ajadismail2/Visual-place-learning/readme.md

# Visual place-learning apparatus

Practical documentation for assembling and operating the visual place-learning arena.

## Build and check

Requires Python 3.10 or later.

[Website](https://ajadismail2.github.io/Visual-place-learning/)
