ajadismail2/Visual-place-learning/docs/hardware/arena-and-dimensions.md

---
title: Arena and dimensions
description: The walking surface, perimeter, glass cover and supporting structure.
section: Hardware
---
A ring and glass cover enclose the temperature-controlled walking surface, with an LED panorama around it and a camera above.

## Current arena specification

| Feature | Documented configuration |
| --- | --- |
| Background | 60 Peltier modules operated as one circuit |
| Cooling Peltier plates | Four separately driven Peltier plates, A–D |
| Visual enclosure | Eight P4 HUB75 panels, 64 × 32 pixels each, 4mm Pixel Pitch |
| Thermal Ring dimensions | 8 inches |
| Glass cover | 2-3mm thick Annealed glass |
| Background sensor setpoint | 34.8 °C |
| Ring sensor setpoint | 50 °C |

## Walking surface and Peltier plates

<figure markdown="1" style="border: 1px solid #d6d6d6; padding: 12px; margin: 24px 0; text-align: center;">

60-Peltier background array

<figcaption>60-Peltier background array.</figcaption>

</figure>

Mount the four Peltier plates flush with the background, with no accessible gaps.

Label the Peltier plates A–D using the tested driver mapping, and retain these labels in recordings and analysis.

## Base and mounts

Mount the carrier on a rigid, level base. Supports and cables must not tilt the floor or obstruct the camera.

See [CAD and printed parts](../cad/parts-and-step-files.md) for the component overview.

## Ring and glass cover

The ring and glass cover enclose the walking surface. See [Thermal ring and glass cover](thermal-ring-and-glass-cover.md) for fit and handling.
