ajadismail2/Visual-place-learning/docs/hardware/overview.md

---
title: Hardware
description: Arena, thermal control, visual display and recording.
section: Hardware
---

<figure markdown="1" style="border: 1px solid #d6d6d6; padding: 12px; margin: 24px 0; text-align: center;">

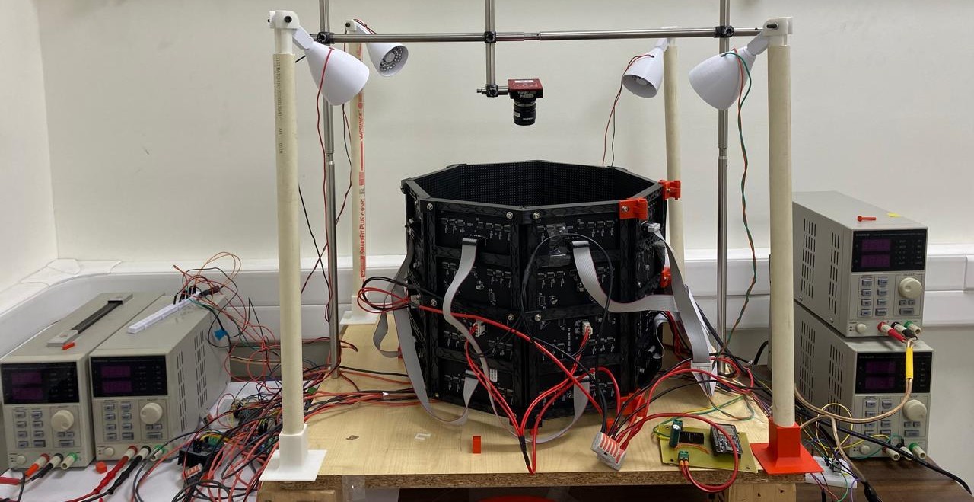
[picture p3: docs/hardware/images/full-arena.jpeg]
Arena viewed from above


<figcaption>Visual Place Learning Arena.</figcaption>

</figure>

The apparatus combines a heated walking arena, four cooling Peltier plates, an LED panorama and overhead video recording.

## Experimental setup

One Peltier plate cools during each trial while the other three heat. The Peltier-plate ESP32 synchronises the selected position with the visual panorama; the background and ring run independent temperature-control loops.

The Setup in total consists of the Peltier arena, Peltier temperature system, LED display, thermal ring and glass cover, illumination,wiring and cameras.

## Configuration

Pin maps and timings match the published sketches. Supply ratings and fabrication tolerances depend on the installed components.

[Equipment list](equipment-and-materials.md) · [Software setup](../software/install-and-upload.md) · [CAD parts](../cad/parts-and-step-files.md)
