ajadismail2/Visual-place-learning/docs/hardware/peltier-temperature-system.md

---
title: Peltier temperature system
description: Peltier plates, series wiring and the shared aluminium heat sink.
section: Hardware
---
A Peltier module transfers heat from one face to the other when current passes through it. Reversing the current swaps the hot and cold faces. Cooling depends on removing heat from the hot face.

<figure markdown="1" style="border: 1px solid #d6d6d6; padding: 12px; margin: 24px 0; text-align: center;">

Peltier module

<figcaption>Peltier module.</figcaption>

</figure>

<figure markdown="1" style="border: 1px solid #d6d6d6; padding: 12px; margin: 24px 0; text-align: center;">

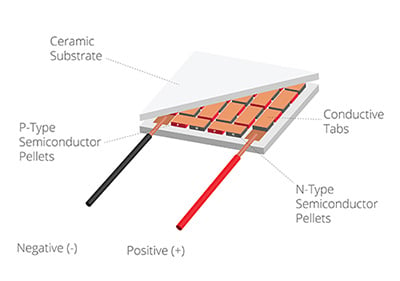
[picture p6: docs/hardware/images/peltierplateinsideworking.jpg]
Internal structure of a Peltier module


<figcaption>Internal structure of a Peltier module.</figcaption>

</figure>

## Arena arrangement

The background uses 60 Peltier modules connected in series to a single power source. The same current passes through every module, and their voltage drops add together.

Four separate Peltier plates at positions A–D provide the cooling locations within the heated background.

## Shared heat sink

The Peltier modules share a common heat sink: an aluminium plate 4–5 mm thick beneath the arena. Good thermal contact spreads heat into the plate, while airflow beneath it helps carry heat away.
