ajadismail2/Visual-place-learning/docs/hardware/index.md

---
title: Hardware
description: Arena, thermal control, visual display and recording.
section: Hardware
---
The apparatus combines a heated walking arena, four cooling Peltier plates, an LED panorama and overhead video recording.

## Experimental setup

One Peltier plate cools during each trial while the other three heat. The Peltier-plate ESP32 synchronises the selected position with the visual panorama; the background and ring run independent temperature-control loops.

## Assembly

| Component | Assembly checks |
| --- | --- |
| [Arena](../hardware/arena.md) | Level floor, secure supports, sealed Peltier-plate edges |
| [Wiring](../hardware/wiring.md) | Board labels, pin assignments, supply ratings |
| [Peltier temperature system](peltier.md) | Background feedback, A–D mapping and temperature response |
| [LED display](led-panels.md) | Panel order, orientation, bar dimensions |
| [Glass cover](glass-cover.md) | Fit, clearance, camera view |
| [Illumination](illumination.md) | Uniformity, mounting, reflections |
| [Cameras](imaging.md) | Focus, calibration, timing |

## Configuration

Pin maps and timings match the published sketches. Supply ratings and fabrication tolerances depend on the installed components.

[Equipment list](../hardware/equipment.md) · [Software setup](../software/upload.md) · [CAD parts](../cad/index.md)
