ajadismail2/Visual-place-learning/docs/hardware/four-channels.md

---
title: Peltier temperature system
---
<meta http-equiv="refresh" content="0; url=../peltier/#four-cooling-peltier-plates">
<script>window.location.replace("../peltier/#four-cooling-peltier-plates");</script>
The four cooling Peltier plates are documented in [Peltier temperature system](peltier.md#four-cooling-peltier-plates).
