ajadismail2/Visual-place-learning/docs/hardware/thermal-coupling.md

---
title: Peltier temperature system
---
<meta http-equiv="refresh" content="0; url=../peltier/">
<script>window.location.replace("../peltier/");</script>
See [Peltier temperature system](peltier.md).
