ajadismail2/Visual-place-learning/docs/hardware/visual-angle.md

---
title: LED display geometry
---
<meta http-equiv="refresh" content="0; url=../led-panels/">
<script>window.location.replace("../led-panels/");</script>
This material is now in [LED display](led-panels.md#setting-the-bar-width).
