ajadismail2/Visual-place-learning/docs/design/3d_design.md

# 3D Mechanical Design

This section contains the mechanical design files for the visual place learning apparatus.

The designs were created in Onshape and are provided here for reference, reuse, and modification.

[Onshape Link](https://cad.onshape.com/documents/b5f54554fffaaa542def4b71/w/fa5ba09e96b052a03cbcd971/e/47a6f2f114aad485d6089ac8)
