ajadismail2/Visual-place-learning/docs/index.md

---
title: Visual place learning in Drosophila
description: A custom-built system for studying visually guided place learning in individual Drosophila.
section: Home
---

# Visual place learning in Drosophila

This custom-built system is used to study how *Drosophila melanogaster* learns the location of a cool target from surrounding visual cues. This adapts the place-learning assay published by Ofstad, Zuker and Reiser in 2011 using accessible electronics and locally fabricated parts. [1](#reference)

The documentation covers:

- **Experimental procedure:** preparing the apparatus, running trials and recording the experiment.
- **Hardware and assembly:** the arena, Peltier temperature system, visual display, illumination and cameras.
- **Controller software:** installation, configuration and operation of the Arduino and ESP32 programs.
- **Tracking and analysis:** AMADEUS tracking, target registration and behavioural measurements.

This documentation describes the current apparatus and will be updated as the system develops.

## Documentation

1. [Hardware](hardware/overview.md) — components, construction, wiring and imaging.
2. [Software](software/how-the-programs-work.md) — controller programs, installation and operation.
3. [Analysis](analysis/ANALYSISWORKFLOW.md) — tracking, target registration and behavioural measurements.
4. [CAD](cad/parts-and-step-files.md) — editable STEP files for fabricated parts.
5. [Resources](resources/downloads-and-references.md) — downloads, checksums and technical references.

<p class="source-note" id="reference"><strong>1 · Reference</strong><br>Ofstad, T. A., Zuker, C. S. &amp; Reiser, M. B. <em>Visual place learning in Drosophila melanogaster.</em> Nature 474, 204–207 (2011). <a href="https://doi.org/10.1038/nature10131">doi:10.1038/nature10131</a> · <a href="https://pmc.ncbi.nlm.nih.gov/articles/PMC3169673/">Full text</a></p>
