ajadismail2/Visual-place-learning/docs/cad/index.md

---
title: CAD and fabricated parts
description: STEP models and assembly notes for the structural, display, lighting and thermal parts of the arena.
section: CAD
---
Six editable STEP models cover the arena supports, display enclosure, lighting, thermal ring and target registration.

## 01 · Structural baseplate

The wooden baseplate fixes the arena and supports in position. The geometry can also be cut from acrylic, aluminium or another rigid sheet.

[Download the baseplate STEP file](../downloads/cad/wooden-baseplate.step)

<div class="photo-pair"><figure class="photo-slot" data-photo-id="cad-baseplate-part"><figcaption><span>Photo · C01</span><strong>Structural baseplate</strong></figcaption></figure><figure class="photo-slot" data-photo-id="cad-baseplate-fit"><figcaption><span>Photo · C02</span><strong>Baseplate beneath the arena</strong></figcaption></figure></div>

## 02 · LED matrix octagon and access hinge

Printed TPU or PLA legs hold eight 64 × 32 panels in an octagon. One hinged panel opens for loading flies and returns to its recording position.

[Download the LED matrix octagon STEP file](../downloads/cad/led-matrix-octagon.step)

<div class="photo-pair"><figure class="photo-slot" data-photo-id="cad-octagon-part"><figcaption><span>Photo · C03</span><strong>Eight-panel LED octagon</strong></figcaption></figure><figure class="photo-slot" data-photo-id="cad-hinge-fit"><figcaption><span>Photo · C04</span><strong>Openable panel and hinges</strong></figcaption></figure></div>

## 03 · Infrared-light stand

A PVC support carries a printed lampshade, infrared array and diffuser. A printed tube can replace the PVC pipe.

[Download the IR light stand STEP file](../downloads/cad/ir-light-stand.step)

<div class="photo-pair"><figure class="photo-slot" data-photo-id="cad-ir-stand"><figcaption><span>Photo · C05</span><strong>PVC stand and printed lampshade</strong></figcaption></figure><figure class="photo-slot" data-photo-id="cad-ir-array"><figcaption><span>Photo · C06</span><strong>IR array and diffuser</strong></figcaption></figure></div>

## 04 · Thermal ring

The PLA ring contains a copper-wire resistive heater. Small openings provide air exchange.

[Download the thermal ring STEP file](../downloads/cad/thermal-ring.step)

<div class="photo-pair"><figure class="photo-slot" data-photo-id="cad-ring-part"><figcaption><span>Photo · C07</span><strong>Printed thermal ring</strong></figcaption></figure><figure class="photo-slot" data-photo-id="cad-ring-wire"><figcaption><span>Photo · C08</span><strong>Copper-wire path and ventilation gaps</strong></figcaption></figure></div>

## 05 · Cool-spot registration mask

Image the mask before each experiment to register the four target positions. Remove it before introducing flies without changing camera framing.

[Download the cool-spot mask STEP file](../downloads/cad/cool-spot-mask.step)

<div class="photo-pair"><figure class="photo-slot" data-photo-id="cad-mask-part"><figcaption><span>Photo · C09</span><strong>Cool-spot registration mask</strong></figcaption></figure><figure class="photo-slot" data-photo-id="cad-mask-view"><figcaption><span>Photo · C10</span><strong>Mask visible in the camera image</strong></figcaption></figure></div>

## 06 · Peltier-plate holder and fan support

The holder stabilises the baseplate around the four Peltier plates and supports a fan below. Underside airflow removes heat from the cooling hardware.

[Download the Peltier-plate holder STEP file](../downloads/cad/peltier-tile-holder.step)

<div class="photo-pair"><figure class="photo-slot" data-photo-id="cad-tile-holder"><figcaption><span>Photo · C11</span><strong>Peltier-plate holder</strong></figcaption></figure><figure class="photo-slot" data-photo-id="cad-fan-fit"><figcaption><span>Photo · C12</span><strong>Fan position beneath the baseplate</strong></figcaption></figure></div>
