ajadismail2/Visual-place-learning/docs/assets/analysis/analysis-gui.png

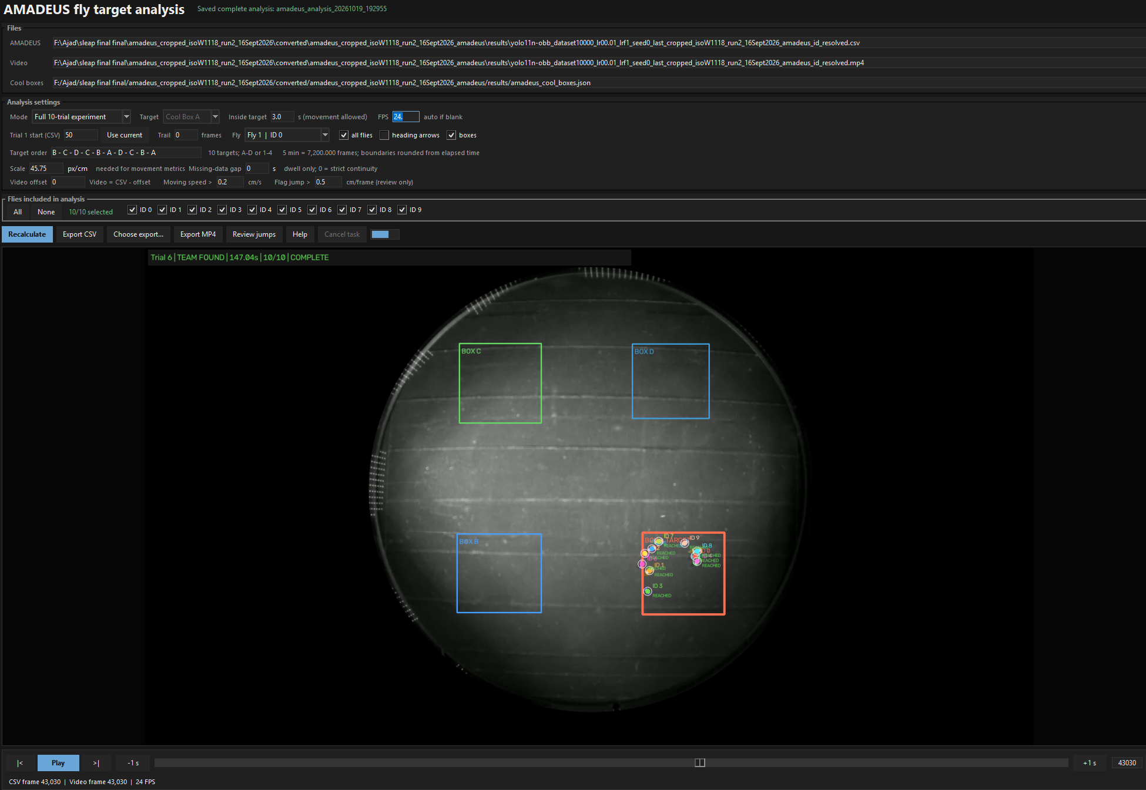
docs/assets/analysis/analysis-gui.png
