ajadismail2/Visual-place-learning/docs/cad/images/Octagon-Holder.png

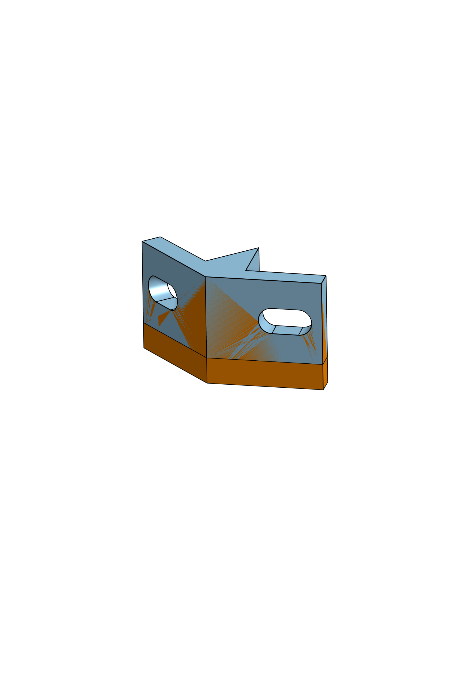
docs/cad/images/Octagon-Holder.png
