ajadismail2/Visual-place-learning/docs/cad/images/Peltier Tile Holder.png

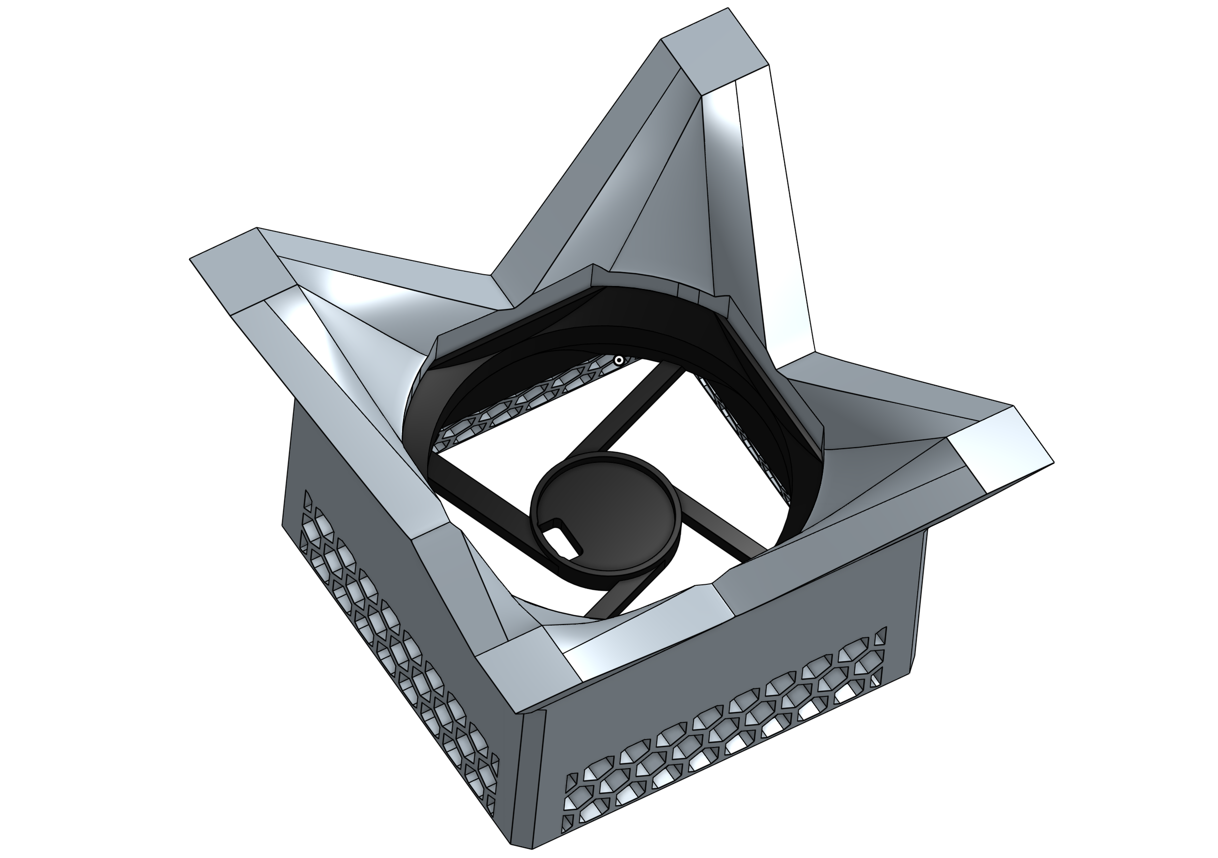
docs/cad/images/Peltier Tile Holder.png
