ajadismail2/Visual-place-learning/docs/cad/images/PVC IR STANDE.png

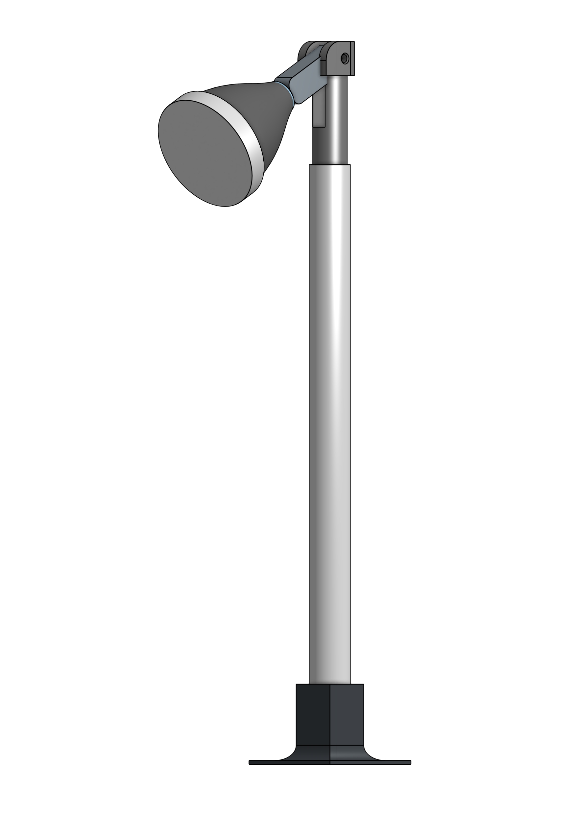
docs/cad/images/PVC IR STANDE.png
