ajadismail2/Visual-place-learning/docs/downloads/website-dynamic-qr.png

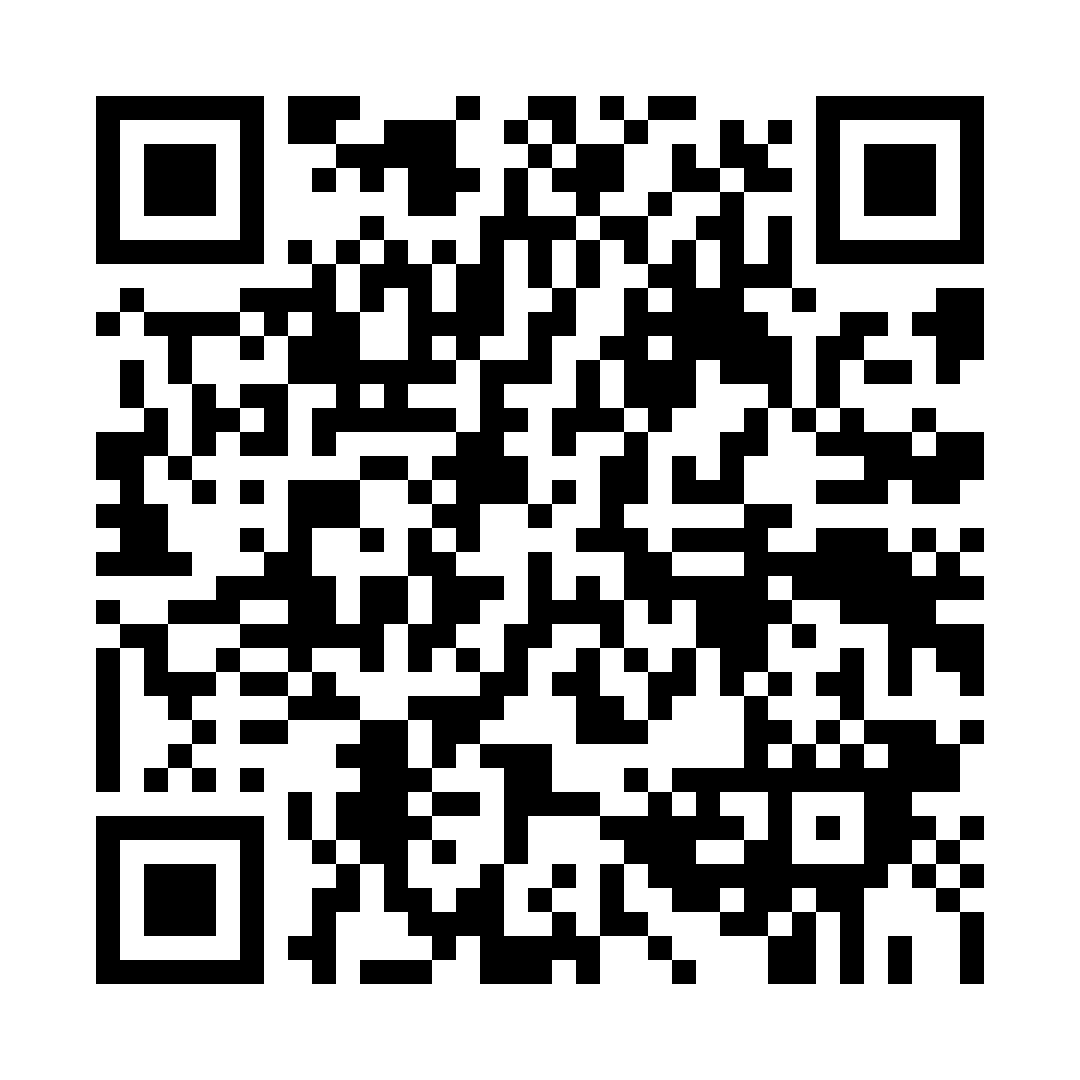
docs/downloads/website-dynamic-qr.png
