ajadismail2/Visual-place-learning/docs/downloads/website-qr.png

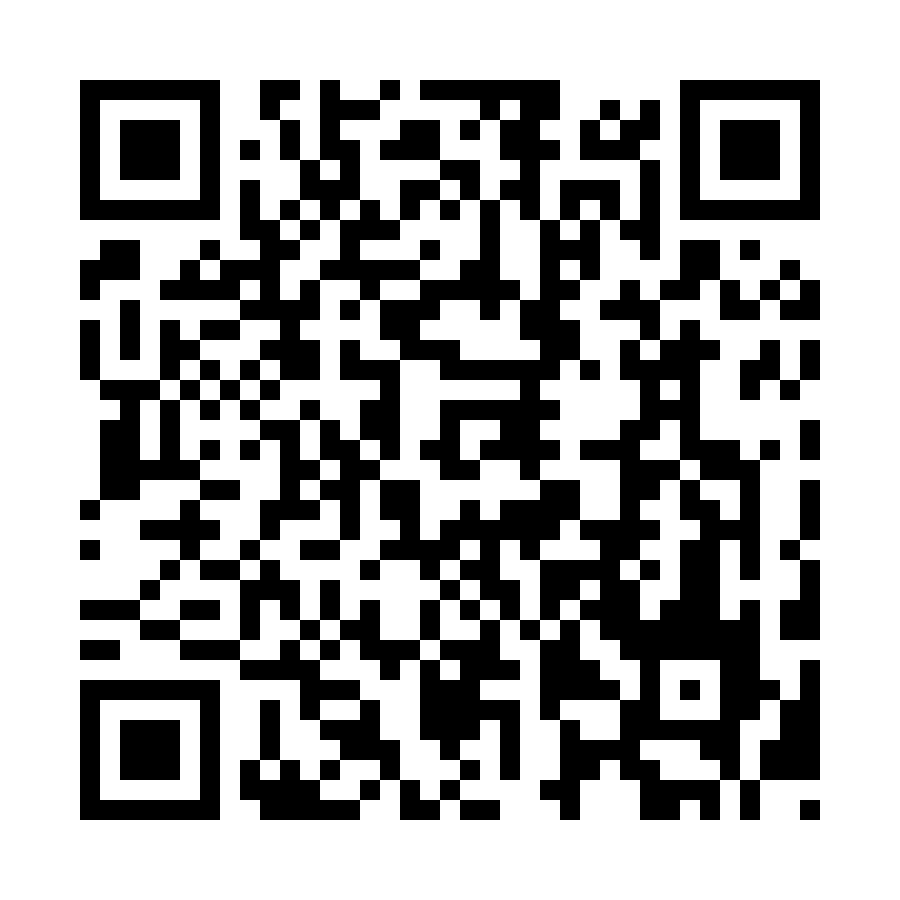
docs/downloads/website-qr.png
