ajadismail2/Visual-place-learning/docs/hardware/images/3dprint.png

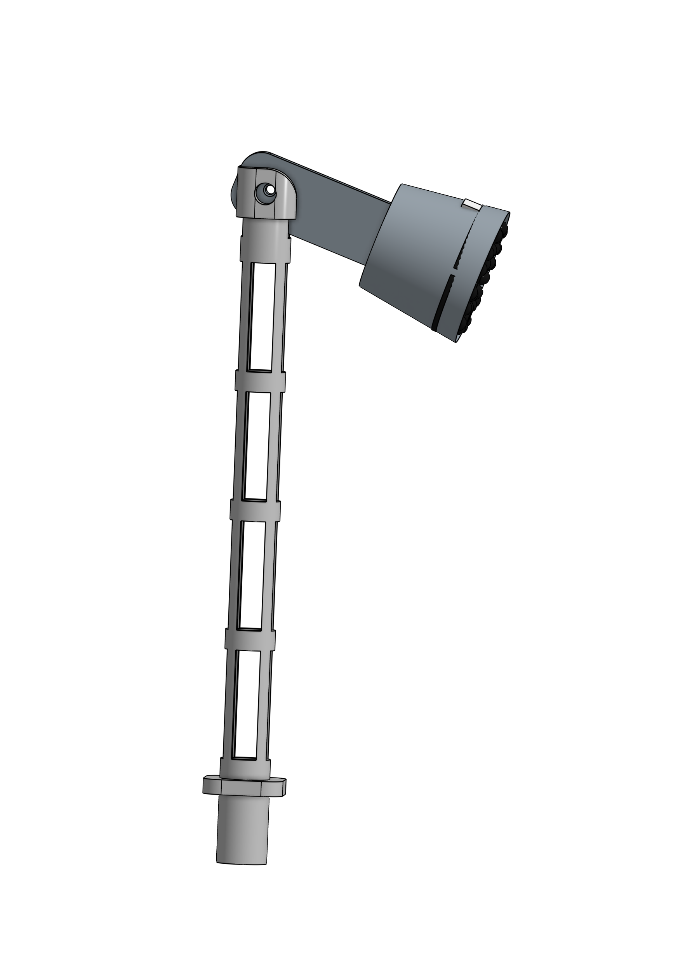
docs/hardware/images/3dprint.png
