ajadismail2/Visual-place-learning/docs/hardware/images/arduinouno.jpg

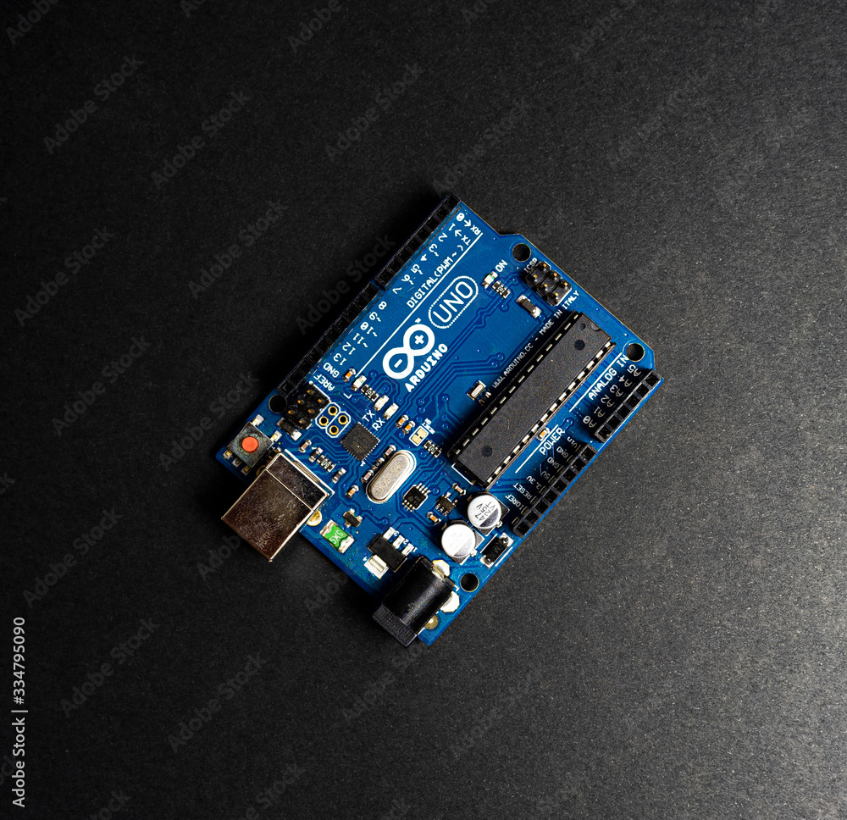
docs/hardware/images/arduinouno.jpg
