ajadismail2/Visual-place-learning/docs/hardware/images/circleflatglass__37330.jpg

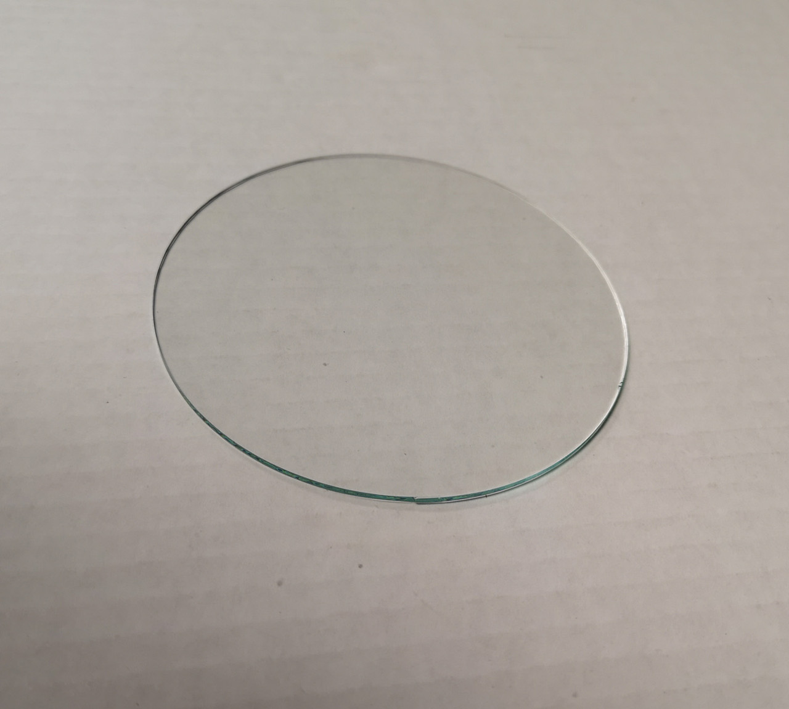
docs/hardware/images/circleflatglass__37330.jpg
