ajadismail2/Visual-place-learning/docs/hardware/images/full.png

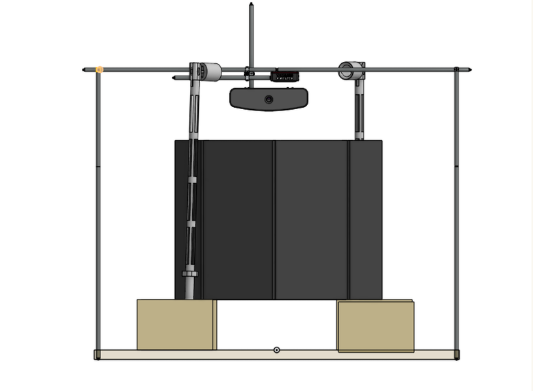
docs/hardware/images/full.png
