ajadismail2/Visual-place-learning/docs/hardware/images/Part Studio 1.png

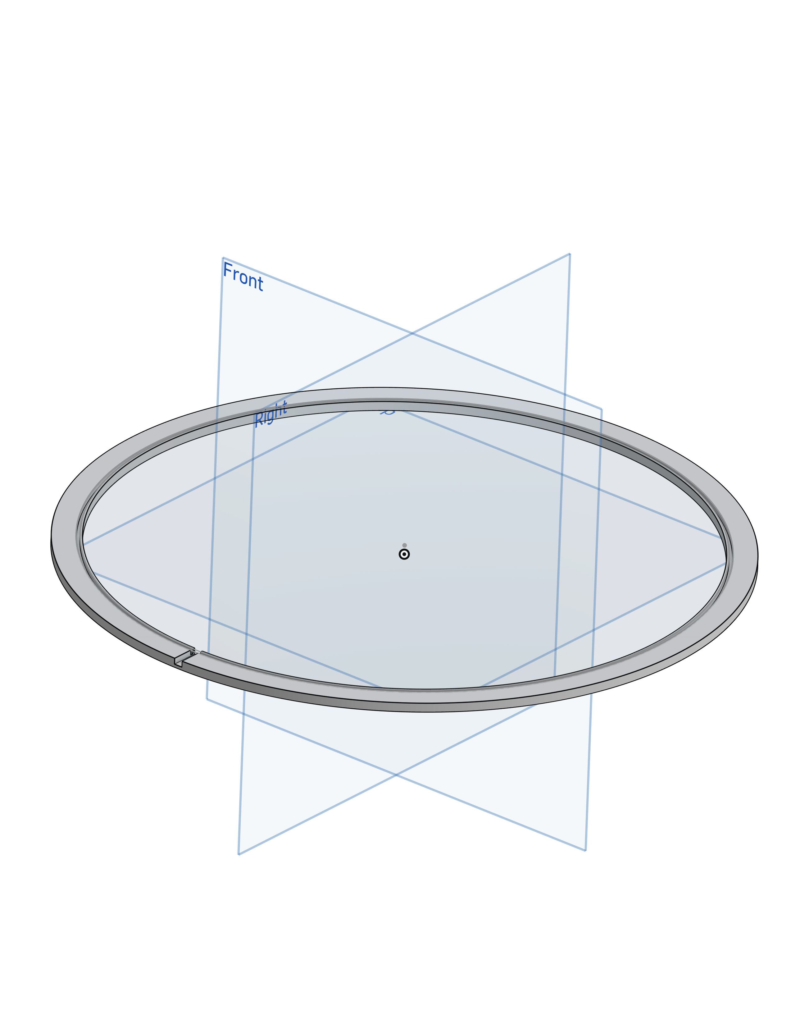
docs/hardware/images/Part Studio 1.png
