ajadismail2/Visual-place-learning/docs/hardware/images/sensitivity.jpg

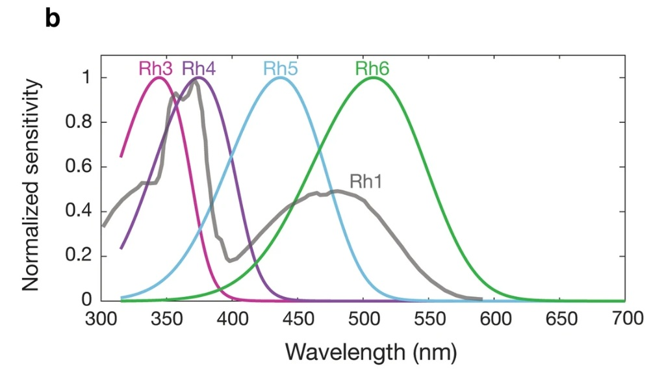
docs/hardware/images/sensitivity.jpg
