ajadismail2/Visual-place-learning/docs/hardware/images/thermalring.jpeg

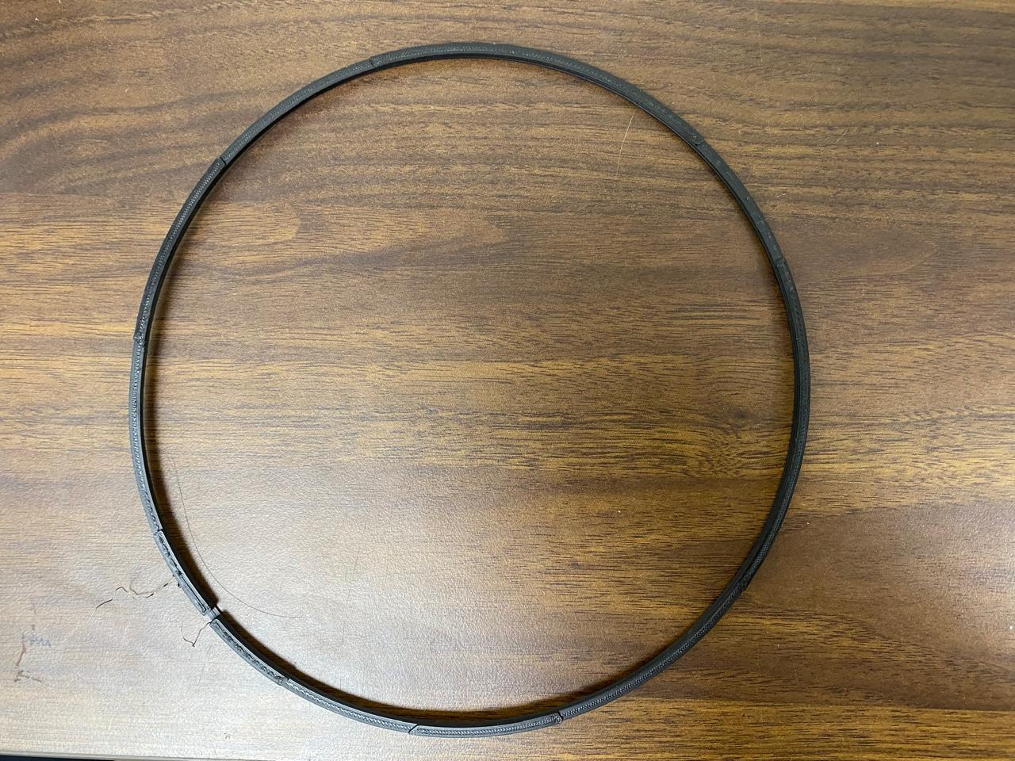
docs/hardware/images/thermalring.jpeg
