ajadismail2/Visual-place-learning/docs/cad/parts-and-step-files.md

---
title: CAD and fabricated parts
description: STEP models and assembly notes for the structural, display, lighting and thermal parts of the arena.
section: CAD
---

## [Full CAD Design](https://cad.onshape.com/documents/51cb519a2868e246f36d1018/w/36f1903476a821ee69db6791/e/1676d93c2aac02087ee3064d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)

## 01 · Structural baseplate

The wooden baseplate fixes the arena and supports in position. The geometry can also be cut from acrylic, aluminium or another rigid sheet.

<figure markdown="1" style="border: 1px solid #d6d6d6; padding: 12px; margin: 24px 0; text-align: center;">

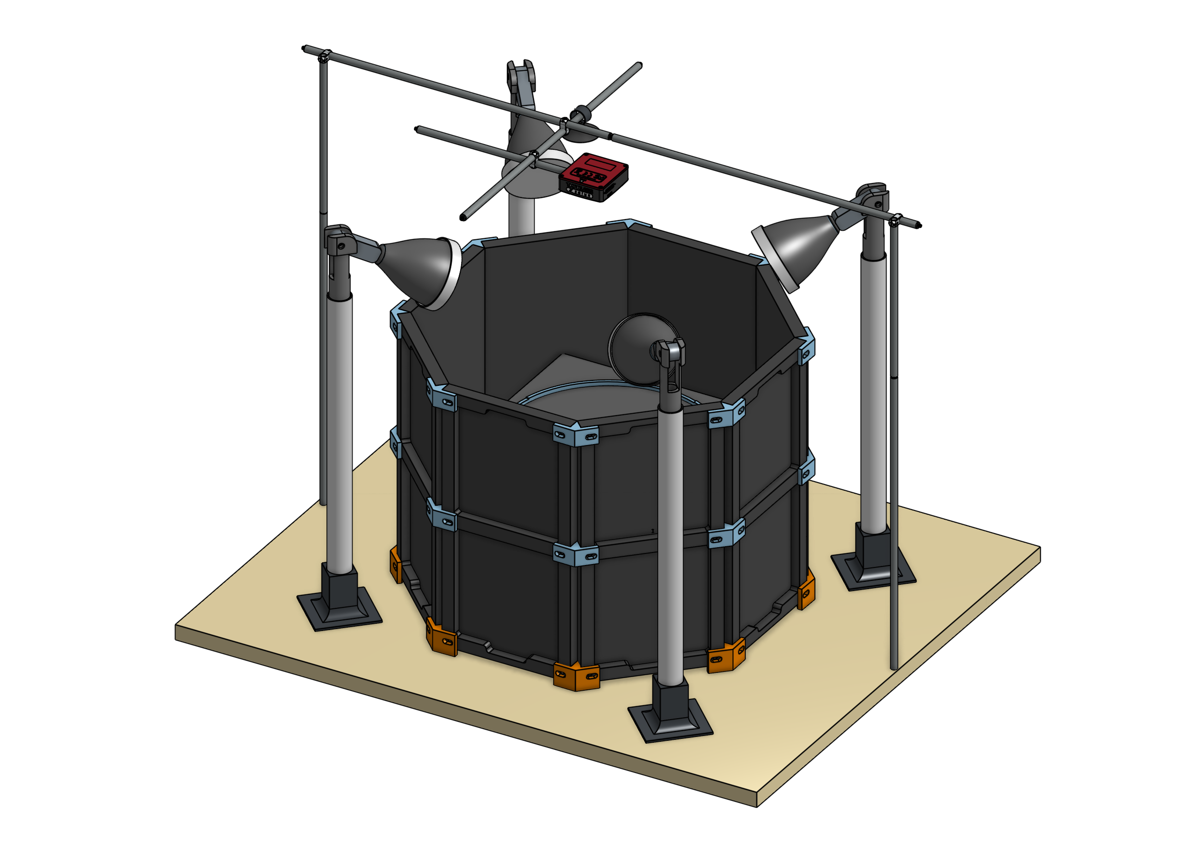
[picture p35: docs/cad/images/Assembly_1.png]
Wooden baseplate


<figcaption>Structural baseplate.</figcaption>

</figure>

[Download the baseplate STEP file](../downloads/cad/wooden-baseplate.step)

## 02 · LED matrix octagon and access hinge

Printed TPU or PLA legs hold eight 64 × 32 panels in an octagon. One hinged panel opens for loading flies and returns to its recording position.

<figure markdown="1" style="border: 1px solid #d6d6d6; padding: 12px; margin: 24px 0; text-align: center;">

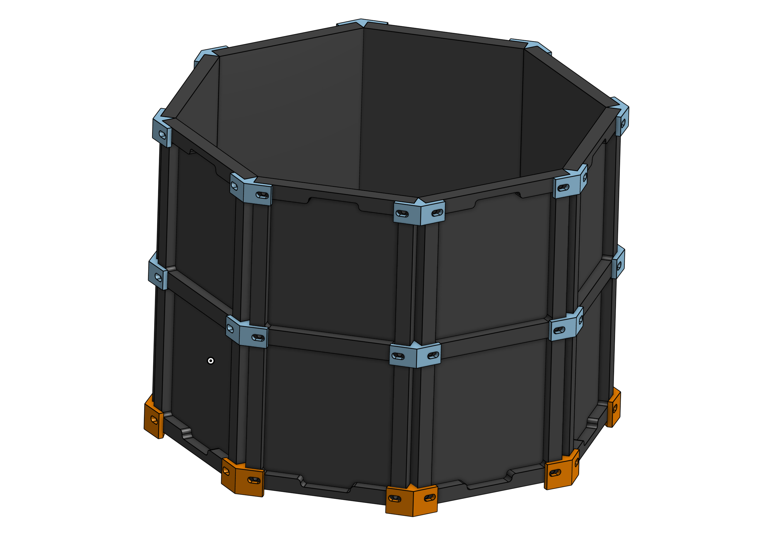
[picture p36: docs/cad/images/LED-Matrix-Octagon.png]
LED matrix octagon with access hinge


<figcaption>LED matrix octagon and access hinge.</figcaption>

</figure>

[Download the LED matrix octagon STEP file](../downloads/cad/led-matrix-octagon.step)

## 03 · Infrared-light stand

A PVC support carries a printed lampshade, infrared array and diffuser. A printed tube can replace the PVC pipe.

<figure markdown="1" style="border: 1px solid #d6d6d6; padding: 12px; margin: 24px 0; text-align: center;">

Infrared-light stand

<figcaption>Infrared-light stand with lampshade and diffuser.</figcaption>

</figure>

[Download the IR light stand STEP file](../downloads/cad/ir-light-stand.step)

## 04 · Thermal ring

The PLA ring contains a copper-wire resistive heater. Small openings provide air exchange.

<figure markdown="1" style="border: 1px solid #d6d6d6; padding: 12px; margin: 24px 0; text-align: center;">

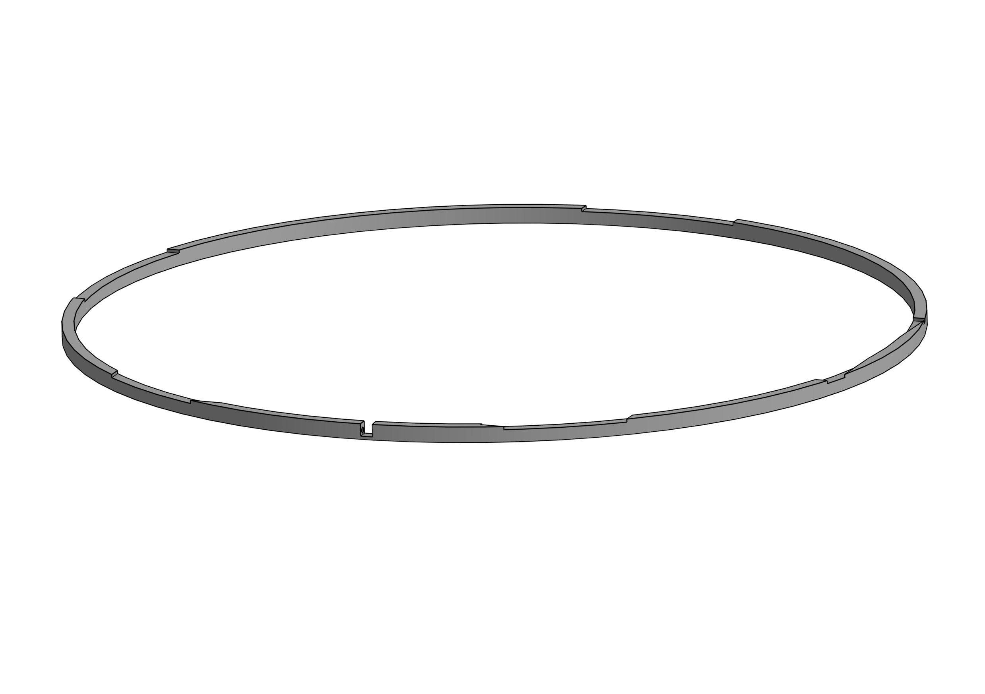
[picture p37: docs/cad/images/thermal-ring.png]
Thermal ring


<figcaption>PLA thermal ring with copper-wire heater.</figcaption>

</figure>

[Download the thermal ring STEP file](../downloads/cad/thermal-ring.step)

## 05 · Cool-spot registration mask

Image the mask before each experiment to register the four target positions. Remove it before introducing flies without changing camera framing.

<figure markdown="1" style="border: 1px solid #d6d6d6; padding: 12px; margin: 24px 0; text-align: center;">

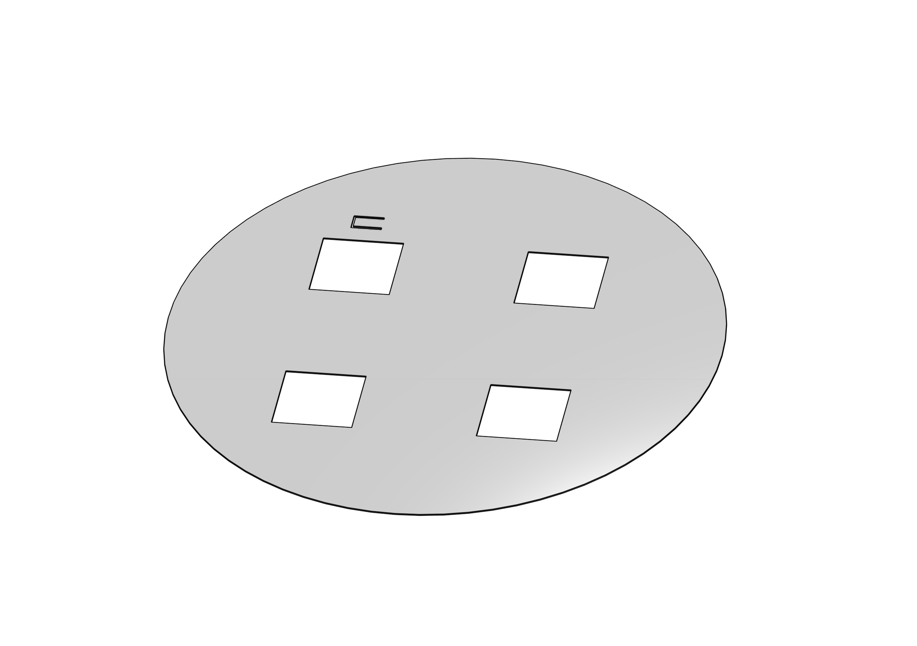
[picture p38: docs/cad/images/mask.png]
Registration mask with four square openings


<figcaption>Cool-spot registration mask.</figcaption>

</figure>

[Download the cool-spot mask STEP file](../downloads/cad/cool-spot-mask.step)

## 06 · Peltier-plate holder and fan support

The holder stabilises the baseplate around the four Peltier plates and supports a fan below. Underside airflow removes heat from the cooling hardware.

<figure markdown="1" style="border: 1px solid #d6d6d6; padding: 12px; margin: 24px 0; text-align: center;">

Peltier-plate holder and fan support

<figcaption>Peltier-plate holder with fan support.</figcaption>

</figure>

[Download the Peltier-plate holder STEP file](../downloads/cad/peltier-tile-holder.step)
