ajadismail2/Visual-place-learning/docs/downloads/cad/led-matrix-octagon.step

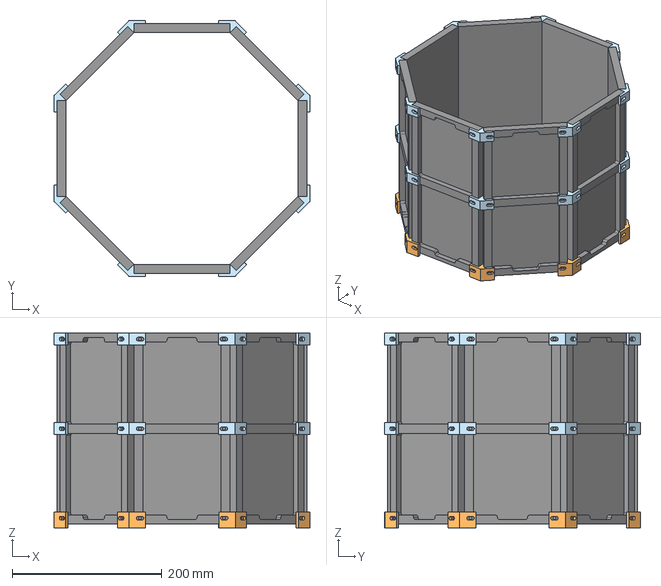
[picture p39: CAD file, 2026-10-22]
docs/downloads/cad/led-matrix-octagon.step
341.6 x 341.6 x 260.0 mm
