ajadismail2/Visual-place-learning/docs/downloads/cad/peltier-tile-holder.step

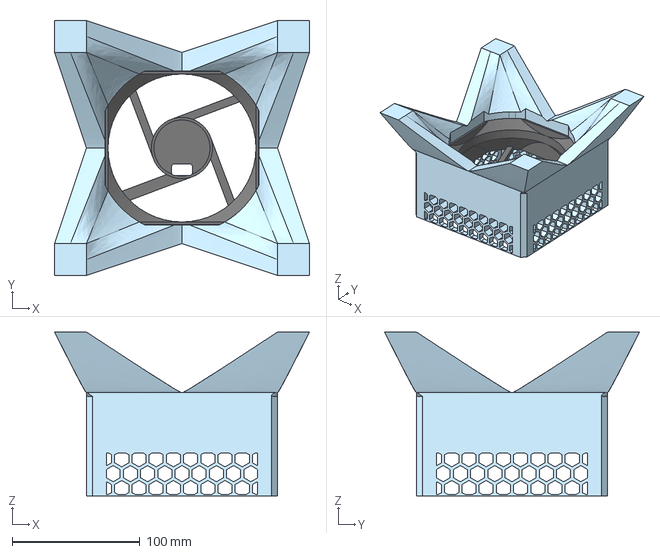
[picture p40: CAD file, 2026-10-22]
docs/downloads/cad/peltier-tile-holder.step
200.0 x 200.0 x 128.6 mm
