ajadismail2/Visual-place-learning/docs/downloads/cad/wooden-baseplate.step

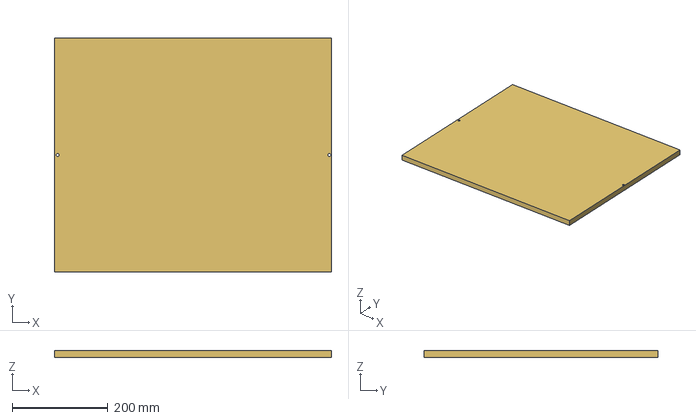
[picture p41: CAD file, 2026-10-22]
docs/downloads/cad/wooden-baseplate.step
580.0 x 490.0 x 15.0 mm
