ajadismail2/Visual-place-learning/docs/downloads/cad/thermal-ring.step

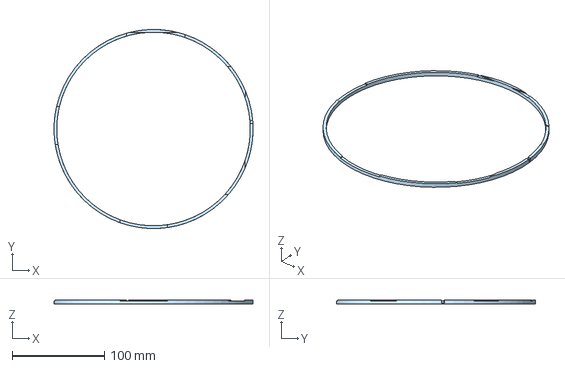
[picture p42: CAD file, 2026-10-22]
docs/downloads/cad/thermal-ring.step
215.9 x 215.9 x 4.00 mm
