ajadismail2/Visual-place-learning/docs/downloads/cad/cool-spot-mask.step

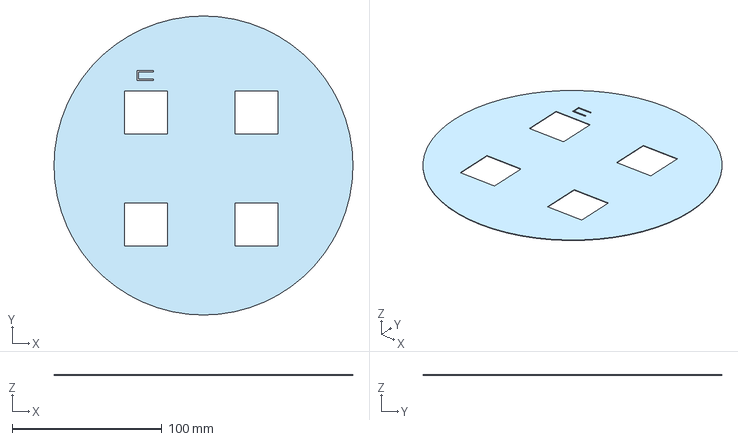
[picture p43: CAD file, 2026-10-22]
docs/downloads/cad/cool-spot-mask.step
200.0 x 200.0 x 0.4 mm
