ajadismail2/Visual-place-learning/docs/downloads/cad/ir-light-stand.step

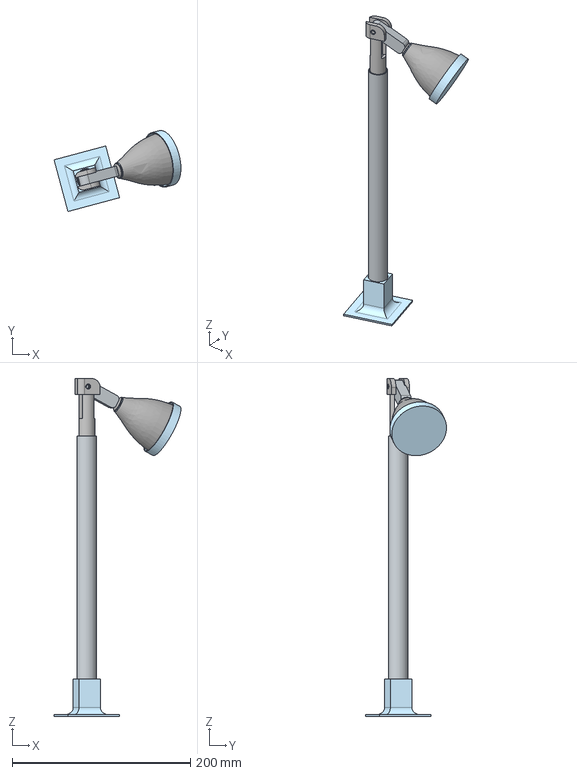
[picture p44: CAD file, 2026-10-22]
docs/downloads/cad/ir-light-stand.step
142.2 x 90.9 x 378.9 mm
