ajadismail2/Visual-place-learning/docs/build/four-channels.md

---
title: Peltier temperature system
---

<meta http-equiv="refresh" content="0; url=../../hardware/peltier/#four-cooling-peltier-plates">

<script>window.location.replace("../../hardware/peltier/#four-cooling-peltier-plates");</script>

This page has moved to [Hardware → Peltier temperature system](../../hardware/peltier/#four-cooling-peltier-plates).
