ajadismail2/Visual-place-learning/docs/build/peltier.md

---
title: Background temperature control
---

<meta http-equiv="refresh" content="0; url=../../hardware/peltier/">

<script>window.location.replace("../../hardware/peltier/");</script>

This page has moved to [Hardware → Peltier temperature system](../../hardware/peltier/).
