ajadismail2/Visual-place-learning/docs/build/visual-angle.md

---
title: LED display
---

<meta http-equiv="refresh" content="0; url=../../hardware/led-panels/">

<script>window.location.replace("../../hardware/led-panels/");</script>

This page has moved to [Hardware → LED display](../../hardware/led-panels/).
