ajadismail2/Visual-place-learning/docs/build/equipment.md

---
title: Equipment and materials
---

<meta http-equiv="refresh" content="0; url=../../hardware/equipment/">

<script>window.location.replace("../../hardware/equipment/");</script>

This page has moved to [Hardware → Equipment and materials](../../hardware/equipment/).
