ajadismail2/Visual-place-learning/docs/build/wiring.md

---
title: ESP32 and Arduino wiring
---

<meta http-equiv="refresh" content="0; url=../../hardware/wiring/">

<script>window.location.replace("../../hardware/wiring/");</script>

This page has moved to [Hardware → ESP32 and Arduino wiring](../../hardware/wiring/).
