ajadismail2/Visual-place-learning/docs/build/arena.md

---
title: Arena and dimensions
---

<meta http-equiv="refresh" content="0; url=../../hardware/arena/">

<script>window.location.replace("../../hardware/arena/");</script>

This page has moved to [Hardware → Arena and dimensions](../../hardware/arena/).
