ajadismail2/Visual-place-learning/docs/assets/arena-wiring-conference.png

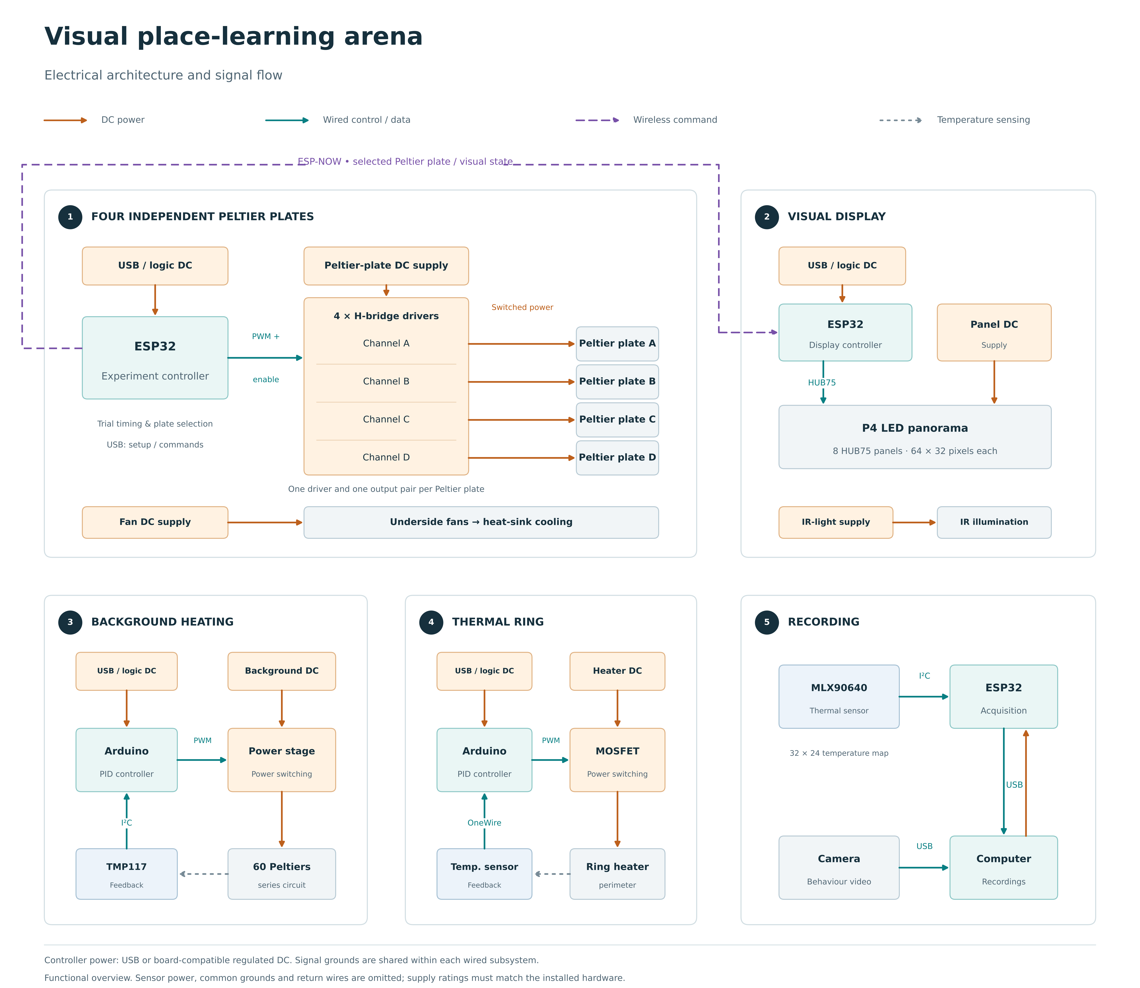
docs/assets/arena-wiring-conference.png
