ajadismail2/Visual-place-learning/docs/validation/thermal-ring.md

---
title: Thermal ring
description: Closed-loop temperature validation of the arena's thermal ring.
section: Validation
---
The thermal ring uses temperature feedback to maintain stable heating. Record the sensor temperature and controller output during a full experiment to confirm that the ring settles near its setpoint without large fluctuations.

This check is useful, but less critical than validating the 60-Peltier background.

<figure markdown="1" style="border: 1px solid #d6d6d6; padding: 12px; margin: 24px 0; text-align: center;">

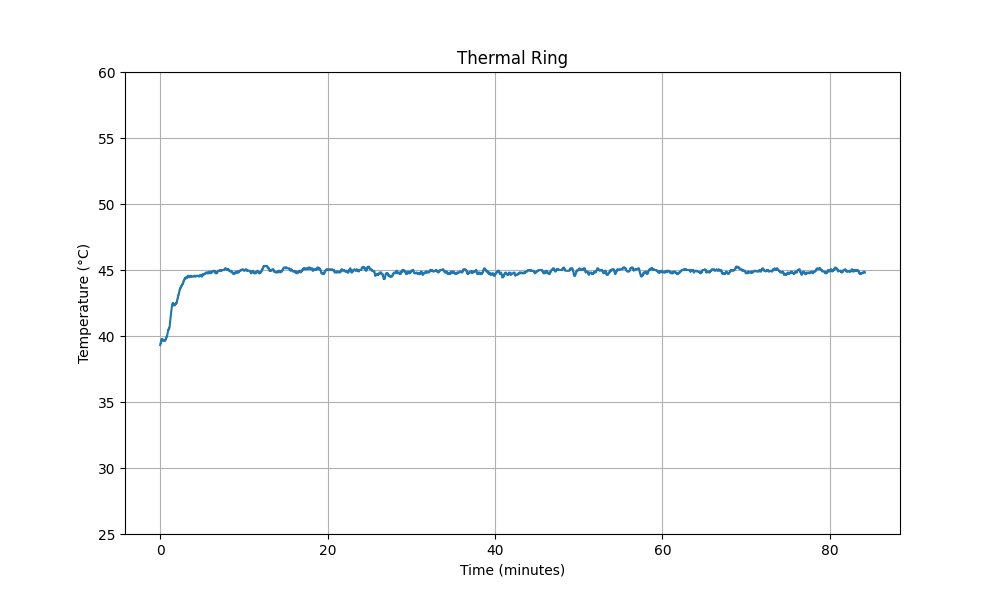
[picture p48: docs/validation/images/thermal ring.png]
Thermal-ring temperature plot


<figcaption>Thermal-ring temperature during an experiment.</figcaption>

</figure>
