ajadismail2/Visual-place-learning/docs/validation/initial-runs.md

---
title: Initial runs
section: Validation
---
## ISO flies

<video controls preload="metadata" style="width: 100%; height: auto;">
  <source src="images/iso-flies.mp4" type="video/mp4">
</video>

## CS flies

<video controls preload="metadata" style="width: 100%; height: auto;">
  <source src="images/cs-flies.mp4" type="video/mp4">
</video>
