ajadismail2/Visual-place-learning/(commit log)

2026-01-06 Create Test UART communication between PyBadge and ESP32
2026-01-06 Rename Test UART communication between PyBadge and ESP32 to Test UART communication between PyBadge and ESP32.py
2026-01-06 Rename Test UART communication between PyBadge and ESP32.py to Software/Test UART communication between PyBadge and ESP32.py
2026-01-06 Rename Software/Test UART communication between PyBadge and ESP32.py to Software/Test UART communication between PyBadge and ESP32/Pybadge.py
2026-10-14 Redesign research website and document current apparatus and analysis
2026-10-17 Publish concise apparatus manual, firmware sources, wiring and website QR code
2026-10-21 Expand apparatus manual into Hardware, Software and CAD
    Add practical setup and wiring instructions, photo placeholders and a CAD outline. Refresh the colour scheme, remove PCB and separate published-specification chapters, and align the display download with the latest supplied sketch.
2026-10-21 Use experiment/display controller names and remove UART hot-output program
    Update documentation, diagrams, sketch names, source labels and configuration example consistently. Remove the unused UART page and sketch from downloads and the firmware bundle. Preserve experiment timing, wiring assignments and control commands.
2026-10-22 Add conference wiring overview to Hardware with updated controller label
2026-10-22 Restore complete full-resolution wiring PNG
2026-10-22 Publish CAD models and fabrication notes
2026-10-22 Restore complete LED octagon and tile holder STEP files
2026-10-26 Add LED panel selection and DMA library documentation with research references
2026-10-26 Add low-cost illumination and behaviour/thermal camera chapters
2026-10-26 Refine hardware sections and consolidate LED display documentation
2026-10-27 Retain emphasis for key temperature and wiring limits
2026-10-27 Shorten display, illumination, camera and Peltier documentation
2026-10-27 Add hardware image to esp32-and-arduino-wiring.md
2026-10-27 Add hardware image to led-display.md
2026-10-27 Add hardware image to cameras.md
2026-10-27 Add hardware image to peltier-temperature-system.md
2026-10-27 Resolve image conflict in cameras.md
2026-10-27 Resolve image conflict in led-display.md
2026-10-27 Resolve image conflict in peltier-temperature-system.md
2026-10-27 Revise 60-Peltier background temperature documentation
    Updated video source and improved section formatting.
2026-10-27 Rename LED Matrix Octagon.png to LED-Matrix-Octagon.png
2026-10-27 Rename Octagon_Hinge_and_Catch (1).png to Hinge.png
2026-10-27 Revise equipment specifications in documentation
    Updated specifications and descriptions for temperature system components, controllers, and display in the equipment and materials documentation.
2026-10-27 Update table headers in wiring documentation
